Board-Folk/Neptune/helpers/Neptune-Region-Fix/images/Nep_rf_1.jpg

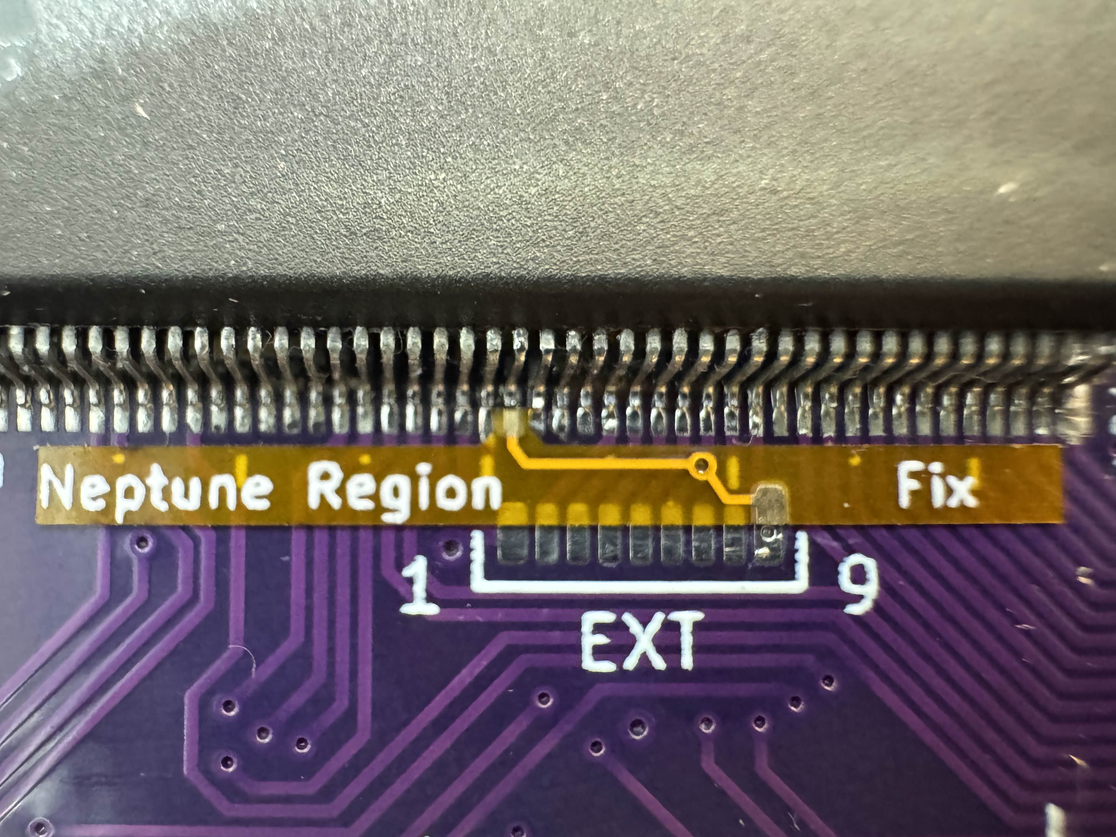
helpers/Neptune-Region-Fix/images/Nep_rf_1.jpg
