Board-Folk/Neptune/helpers/Neptune-Region-Fix/images/Nep_rf_2.jpg

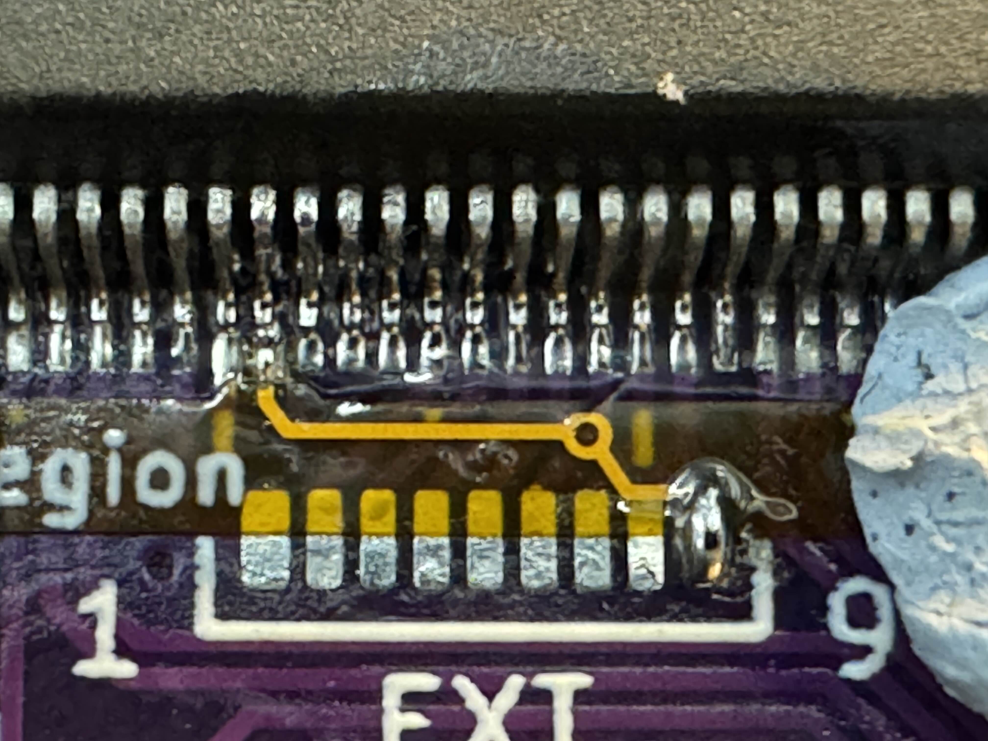
helpers/Neptune-Region-Fix/images/Nep_rf_2.jpg
