Board-Folk/Neptune/helpers/Neptune-Region-Fix/images/Nep_rf_3.jpg

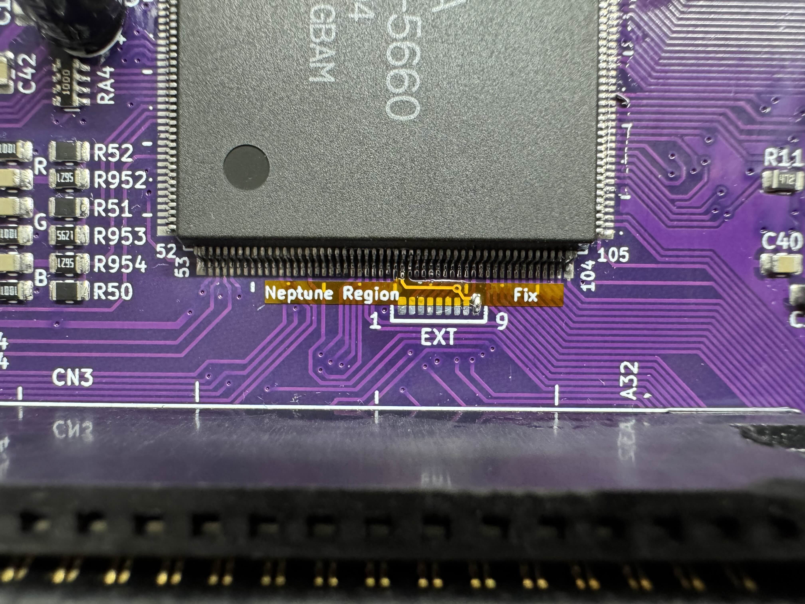
helpers/Neptune-Region-Fix/images/Nep_rf_3.jpg
