Board-Folk/Neptune/helpers/Neptune-Region-Fix/images/Nep_rf_4.jpg

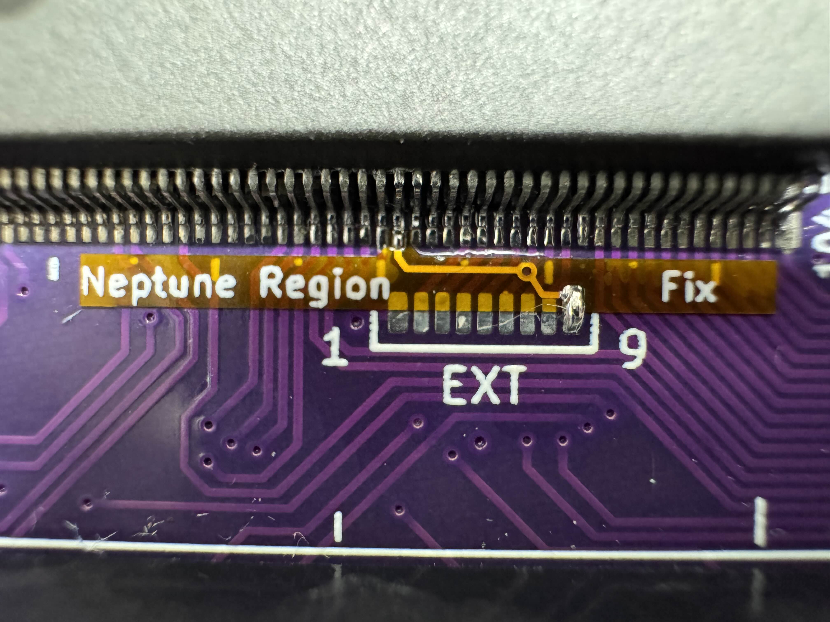
helpers/Neptune-Region-Fix/images/Nep_rf_4.jpg
