Board-Folk/Neptune/(threads)

Thread 1 (2025-01-19):

BOM Contains only minimal information

DoctorDan1986, 2025-01-19:
I'm astonished that the iBOM does not contain any information regarding capacitor voltages or tolerances.  Are we just supposed to throw 16V+ 0.1% parts at everything?

SteveMaddison, 2025-01-20:
1000 apologies (+/- 5%) that the BOM does not meet your standards. The first step would be to adjust your expectations; this is a hobby project with limited resources, worked on in normal people's spare time and provided free of charge. Second step would be to apply common sense as opposed to sarcastically proposing ridiculously narrow specifications.

The capacitor voltages are not even on the original schematics in most cases. They are however, rather conveniently, printed on the actual parts fitted to the donor hardware you would need to obtain in order to populate the board. As for tolerances, typically 20% is adequate for this kind of system. There are also capacitor lists for both the MD2 and 32X online. One can even order complete kits for these consoles from various suppliers.

I shall, time permitting (unless some kind soul were to offer a pull request for this) transfer the voltages where known to the BOM but, frankly, this kind of entitled attitude does not exactly inspire great motivation to do so.

dubesinhower, 2025-03-08:
I know it's not a perfect solution, but if you use the PCBWay plugin to send the project from KiCad to PCBWay, the plugin does some decent LCSC part mapping. You just need to download the generated BOM from the PCBWay order page.

From there, I deleted all rows with no LCSC part mapping (these parts can be obtained from the donor boards), and parts with values that start with "*".

Then upload that BOM to LCSC and see what issues need to be resolved (combining duplicates, finding replacements for OOS parts, etc).

You will also need cap kits for both the genesis 2 and the 32x, I got mine from Console5.

Note that I have a PCBWay sponsorship, but I thought this advice was helpful even if you don't plan to order the board from them.

I am not affiliated with Console5.

Nascar1243, 2025-03-11:
Is there any way this BOM could be converted so that I can use it on sites like Digi-Key or JLCPCB as I already ordered the board but need to get the parts and the BOM does not convert well at all with Digi-Key's site.  I don't want to manually enter in 100 different parts if I don't have to.

SteveMaddison, 2025-03-12:
There are some DigiKey part numbers in there, the column may need to be unhidden. Also the MPN is in there for most parts and can be used to order from various suppliers.

dubesinhower, 2025-03-12:
Also it doesn't seem to do anything with the PIC and the LED, so you may need to order some parts manually

Nascar1243, 2025-03-12:
Yeah I got them after getting a new BOM with KiCAD, although I am noticing a lot of caps with * as their value, what do I need to do with them?

dubesinhower, 2025-03-12:
AFAIK these are "DNP" or do not place and you can ignore them, but I haven't confirmed that yet

SteveMaddison, 2025-03-28:
The "*" is how they're labeled on the original schematics and means that the value (or presence in some cases) differs between various revisions/regions. The known differences are listed on the schematics to avoid trying to explain it all in the "value" field of a component. Sega also loved to place low value caps on various signals to compensate for timing issues in the hardware, so I've kept footprints for most of those just in case some revision happens to need them. The basic rule is to use what's on your donor - if it doesn't have it, it was never required in the first place.

dubesinhower, 2025-03-28:
> The "*" is how they're labeled on the original schematics and means that the value (or presence in some cases) differs between various revisions/regions. The known differences are listed on the schematics to avoid trying to explain it all in the "value" field of a component. Sega also loved to place low value caps on various signals to compensate for timing issues in the hardware, so I've kept footprints for most of those just in case some revision happens to need them. The basic rule is to use what's on your donor - if it doesn't have it, it was never required in the first place.

yea I'm just now learning that I was incorrect about the * parts!

SteveMaddison, 2025-03-29:
That sure looks like the diode indeed. The small resistor-looking thing may be the capacitor or there might not be one, not sure.

Silverymoon-lab, 2025-04-29:
This [document ](https://limewire.com/d/FRYD1#cw5XeDaozu)could have the information you are looking for.

Closed 2025-06-06.

Thread 2 (2025-03-27):

Request for clarification on some parts

jjh13, 2025-03-27:
I'm building this out from a VA1 NTSC genesis motherboard (and a VA0 32x), for the most part everything is going very smoothly. But I'm having a few issues with the labels of some components. My notes so far:

- The resistor arrays look mislabeled: RA3 should be a 2x package on the mega drive (RA6 is the 2x in the schematic); not a huge problem, since they're all the same value, but it's worth noting this (this tripped me up for a hot second).
- Looks like there also aren't enough 22nF capacitors on an NTSC motherboard to salvage. I have a second donor board, and ordered a bunch of additional parts so I'll be good.
- C15 is missing on all my VA1 motherboards; so I assume it is to be omitted. Might be worth noting.
- Is R45 supposed to be 0 ohms? It's definitely non-zero on the mega drive (I can't see it well without a microscope, so I can't read the rating). Perhaps it should be labeled R545? Although I don't know what R545 is, I'd need to look at my 32x (edit: yes R45 is 0 ohm on the 32x).

It's a very fun build so far though; I appreciate how well documented the project is despite one or two little hiccups.

SteveMaddison, 2025-03-28:
Thanks for the feedback.

* I've swapped RA3 and RA6
* R45 was meant to be the 32X part, is now R545

For donor parts, it's about transferring what's on the donors to the new board. What's not on the originals isn't required. I think you've figured it out but I've added a general note about it to the README.

Good luck with the build! I'll close this issue now but feel free to open another if you notice anything else.

jjh13, 2025-03-28:
Thanks! l verified as much as I can with the MD portion (probing around, I'm seeing signals that I expect, and my model 1 CD boots games; I think... not that I can see them...)  I'm moving on to the 32x portion of the build later tonight; I think I noticed some differences, but I'll take notes then open a new issue if there's anything meaningful (I need to study the schematic a bit before I jump into it.)

Closed 2025-03-28.

Thread 3 (2025-05-21):

Region of system flickers in 240P Test Suite, Gentest Test Rom, and Version Register flickers between A1 (81 if Sega CD is attached), D5, and FF

noobguy57, 2025-05-21:
When using 240P Test Suite on the Neptune, in the bottom right corner you will notice the region of the system flicker between North America and Europe. Further investigating this, on the Gentest Test Rom, the region also flickers back and forth rapidly, and the version register flickers rapidly from A1 to D5 and even FF (which shouldn't be possible).

This seems like a minor issue, and the Neptune passes the MARS Check ROM repeatedly, as well as passing all memory tests in the Gentest Test Rom for the 68000, Z80, and VDP, however in some games there is visual artifacting on the screen. The best demonstration of this is in Streets of Rage 2. The artifacting appears in NTSC mode, but goes away in PAL mode (however the version register and region still flicker in PAL mode).

This also seems to affect Sega CD reliably booting, although the full extent we have not troubleshooted, and a few resets eventually allow this to boot.

[Video](https://cdn.discordapp.com/attachments/817807363050307654/1373788908755619942/IMG_8566.mov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) of the region flicker and register (happens in 240P Test Suite too, and DOES NOT happen with same ROM and same Everdrive on a Tower of Power).

[Video](https://cdn.discordapp.com/attachments/817807363050307654/1373507720606646302/IMG_7538_2.MOV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) of the artifacting in Streets of Rage 2 in NTSC mode (possibly other games too, once again DOES NOT occur on Tower of Power)

This issue occurs on 8 people's Neptunes (as of what we know) with everyone in the Dubesinhower discord having this issue.
This issue also occurs across installs that were both pre-populated birdseed and hand installed birdseed, as well as different PCB manufacturers.

Here is what has been done to troubleshoot:
Verify clock signal with oscilloscope, change crystal, and install Dual Frequency Oscillator (no change)
Verify no shorts on VDP, 68000, Z80, and their respective RAM
Removed PIC and hardwired NTSC or PAL mode to test (no change)
Ensured proper NTSC components installed, and PAL components removed
Ensured proper instructions followed for the diode or SCA chips
Lifted the NTSC pin on the Genesis VDP and tied directly to 5 volts (no change)
Tied a 4.7k resistor between NTSC and 5V at PIC location (no change)
Verified connection of all CLK related lines on board
Verify NTSC line from Genesis VDP is held high all the time via scope (it is held high)

And finally, [here](https://cdn.discordapp.com/attachments/817807363050307654/1373795796306235532/20250518_175341.mp4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) is Streets of Rage 2 on my tower of power, not showing these symptoms, [as well as](https://cdn.discordapp.com/attachments/817807363050307654/1373795565703397428/20250518_175200.mp4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) the same Gentest Test Rom showing a stable region and version register.

We are all out of ideas for what could cause this. At first, when it was one person, it seemed like a short. But then every single person without fail? Now we aren't sure where to go or what to look for next. Any ideas or possible remedies to try?

SteveMaddison, 2025-05-22:
Just adding an extra source of information on the different ASICs we might come across and their known limitations.

https://consolemods.org/wiki/Genesis:ASIC_Information

It would be interesting to see how similar these all are internally but I don't know of anyone decapping any of these chips.

noobguy57, 2025-05-22:
I know some of them contain block diagrams that were from Sega, but not all of them. In the case of the 5660, the NTSC/PAL line is visible on there. Looks like a basic buffer going into the IC, then heads to some bus related lines. Some of the others don't have the block diagram which is annoying. I also don't unfortunately know if anyone has decapped one as well.

Is your build a pure PAL build? Does the region also flicker in 240p Test Suite?

So far we are out of ideas. We also tried with and without the cap array on the data lines from the 68000 going into the VDP, but no change in behavior there either.

dr-goobur, 2025-05-26:
@noobguy57 would you mind re-uploading/posting your videos? I'm not seeing any obvious signs of the region switching you're mentioning in the 240p test suite -- all of my 5 units show no sign of this problem (I think, but I'd like to be sure).

noobguy57, 2025-05-27:
This would be great to try. We believe its on the Genesis side, but it would eliminate 32x bus noise which would give a clue. If you have the means to do this, give it a go!

dr-goobur, 2025-05-27:
> The register isn't actually a physical register. When you read from that register, the NTSC, JAP, and DISC lines gets put to the data bus, which therefore outputs its value. Originally I thought it was a physical register too, but that address simply allows for those lines to be pulled to the data bus and output. So it may be an issue with that bus or noise/impedance on those lines, but we haven't had any huge evidence towards it. As for pulling the 32x VDP high on that line, I don't believe anyone has tried or on the encoder side. People have mainly tried on the Genesis side. Worth a shot!

That makes sense. A physical register (regardless of it being DRAM or SRAM) would be wasteful, and you could very well just multiplex (NTSC, JAP, DISC, 0, 0, 0, 0 ,1) on to the bus.

I lifted the NTSC pin on the video IC; the console boots (IIRC from the service manual, this is pulled high internally) but there's no change.

I'll lift the pin on the 32x VDP (and pull up if necessary) and see if that changes anything.

Although if there's no physical register in the VDP, then I suspect the problem to be on/with the 68k bus. We should removing  the 32x components as @v00dooperson suggests. I don't have the bypass flex cables, but I can remove the 5781, 5818 and 5805 and boot into gentest via a SegaCD (I've tried something similar when debugging my builds, the 5788 still partially works with this configuration, so you get some video out)

I just need to wrangle a windows PC to build the gentest diagnostic iso (and find my stack of blank CDs)

noobguy57, 2025-05-27:
Yeah I am feeling that we are looking at bus noise, I wouldn't count out the Z80 since the 68k accesses Z80 memory starting at $A00000

dr-goobur, 2025-05-28:
I can confirm that the Sega CD will not boot without a Z80 -- it was worth trying. The Z80 is easy to get off (and back on) the board. A thought tho, is it possible to boot without the Z80 if the 5660 never touches the Z80 bus?

I don't see anything in the [TMSS](https://github.com/OrionNavattan/TMSS-Disassembly/blob/main/tmss.asm) that would prevent us from booting without a Z80 (can I get another pair of eyes on that to validate this, thought?). If we use a specialized build of GenTest without any Z80 init, it might be enough to get some code running without a Z80 and see if we can observe the issue. I can burn that to a ROM and build a test cart (to eliminate any chance of a flash cart doing some Z80 init when the menu loads).

I'm really running out of ideas, and I'd like to validate anything we possibly can.

One other line of thought I've been having, is that the caps on the Neptune board are not exactly 1-1 with their counterparts on the original VA1 board. For example, take C52 on my original VA1 board. It's is populated with a 28nF cap (I took it off and measured, should be 22nF according to the VA1 schematic, but I guess that's in spec enough).

C52 looks like it's additional filtering for CE30. The closest equivalent I can find on the Neptune board is C32 (there's no C52). This isn't a problem per se, but it suggests that there could be other labelling issues on the Neptune board. If there was a mistake in the VA1 schematic that @SteveMaddison used as reference for the genesis side of the Neptune, then a naming error could mean that the equivalent component on the Neptune is out of spec (which would affect builds that take all components from the Genesis).

Has anyone transcribed the VA1 schematic into KiCad and laid out a replacement VA1 board? That'd be a good reference to have.

We should probably cross reference the caps/resistors on a VA1 board with their respective locations (not names) on the Neptune boards.

I also have a cheap 8 channel logic analyzer I could hook up, but I don't really know what I should be probing (8 channels is sorta limited, I could probably get a few lines on the address/data bus). I'd like a more specific test-rom before diving into that (i.e. one that reads A10001 over and over in quick succession, just so that I have a high chance of seeing reads from that address). I'm not opposed to buying a 32 channel logic analyzer, but that'd take some time for delivery.

dr-goobur, 2025-05-28:
> You should be able to ensure that the GenTest ROM does not contain any code that accesses the Z80. However, the 5660 does have direct connection to the Z80. The Z80 address and data lines head straight into the 5660. My guess is that it still wouldn't boot. I do have the GenTest source code if we need to make modifications for it. However yes you are right, it would be absolutely best to burn onto a ROM chip since the Everdrive has a very high chance of initializing the Z80.

> In the TMSS source code, the lea into SetupValues is important to note. You can see it loads the Z80 bus request and uses that address in a1 to do some simple and cycle saving math to get to the version register and find the console version. Since you did say you got a TMSS screen without a Z80, we could try to modify the ROM and see. I might heavily modify the ROM so that it only goes to the status screen and shows the version register/region.

The appearance and disappearance of the TMSS suggests that the console is executing code on the m68k, then handing off to cart. However, I need to have the 32x part of the build installed to see the TMSS screen (and I have no idea whether the 32x has a boot rom that runs on the 68k prior to handing control over to a game; that could feasibly init the Z80). I'll look into this probably tomorrow (I have to find my EPROM programmer and UV light; plus I have some plans tonight.)

> I don't think anyone has transcribed the schematic, I think that is a good idea though. My guess is [@SteveMaddison](https://github.com/SteveMaddison) would have more context on some of those components. When I talked to some of the folks that help develop Genesis emulators, they suggested simply looking at the address and data bus of the 68k and Z80 with an oscilloscope and to make sure all the edges look very clean, things like that. Logic analyzer you might be able to get the entire Z80 data bus with just those 8 channels, which is what we are looking at anyways. Could help rule in or out the Z80.

I've been probing the M68k address and data lines with my scope. (I haven't thought to probe the Z80 lines, because they're on the back of the board, I'll try that at some point). TBH, I'm not exactly sure what "clean" means here. There's what I would call "strange behaviour" on some of the m68k address lines, and the data lines look wonky. But I see that same behaviour on my model 1 (no 32x, just booting the test rom from CD, and the problem is not present on my model 1). I've been avoiding mentioning this because I'm not sure if my test setup is reliable, and I don't think I quite have the "golden eye" to determine a signal's quality.

I'm not confident that the logic analyzer I have will be useful, but I'll also give that a shot -- I say 8 channels, but it's really only 7 because one's dedicated for a clk signal (I think, I don't have it in hand right now). I'll probably buy the 32 channel analyzer anyway (because I want it), but it'll be a while before it gets here and becomes a viable avenue for testing.

Side thought: Perhaps we should branch off GenTest and fill it with a suite of debugging tools for Neptune builds. I have a list of features I'd like from a Neptune test CD (since I do all my testing throughout the build process with a Sega CD). Although, for now I only really want the reads from A10001 blasted to the screen. I understand the code well enough to do this, I think.

dr-goobur, 2025-05-29:
Double posting, I know, but it might be worth talking about.

I'm cross referencing the Neptune schematics with the Genesis VA1 schematics, looks like there's more discrepancies in the filtering for the 5660.

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
So far I see:

 - One cap missing; it's one that I already pointed out, I'm not sure exactly where it's missing though, because it seems like C32 took its place.
 - The resistors R72 and R73 are missing from the Neptune. I was aware of this, but I thought it didn't make a difference. However, they're suspiciously close to the NTSC line, and they look like they're somehow there to limit current. Without them, perhaps something is being charged or discharged too quickly, leading to values being corrupted in some way. Total guess. Maybe @SteveMaddison you can chime in on what those resistors do, and whether or not they may be important.

dr-goobur, 2025-05-29:
Those just connect to the various VCC lines on the 5660, but I don't think they're relevant. I lifted pins 54 and 57; if that affected the register at all I would have seen some change, but no change.

Also, turns out gentest boots fine without the Z80, no adjustments needed (can't boot from a flash cart tho). However, without a Z80, there's no change. I think we can rule out the Z80.

I also tried manually powering the system with a bench supply; no change.
I over-volted to about 5.2v, no change.

Oof, I'm running out of ideas. This appears to be very isolated to the 5660. I'm really going to have to dig into the genesis schematics and continue to cross reference the Neptune schematics.

Perhaps it /is/ simply related to some clock shift and the 18ns shift was too loose, I'll try to get a better setup for probing more signals (I want to capture traces of all the important control signals to the M68k relative to the clock and see if there are any timing discrepancies ).

After that idk. I might call it quits for a bit until I can get a reference model 2 that I can do some experimental surgery on (I'd like to swap in a problematic 5660 to the reference board and see if the issue goes away).

angelsix, 2025-05-29:
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

you need to compare the address and data bus with the !READ pin to see the moment at which the bus sends out the register, what the address is. Or at least compare the rise/fall of the !READ pin vs any address/data to see if it is aligned different than stock

dr-goobur, 2025-05-29:
READ isn't the signal you should care about, that's not quite how the m68k works; READs aren't available in the next cycle, there's a variable delay until the data is on the bus (in theory; but I bet on the genesis it's fixed). It's more reasonable to probe DTACK because it's the acknowledgment that data is valid on the bus.

That being said, I did check read. I actually checked all control signals off of the m86k and I didn't see anything overly suspect. I will get better traces of those when
 1) I have a reference model 2 to compare against
 2) I figure out how to automate my scope setup (saving waveforms on my scope is not trivial for some reason) But even then, getting the exact.
Even still, getting this to trigger on the exact instruction that shows the problem is not trivial, especially since it's a relatively rare occurrence. The easiest thing I can do is compare the waveforms of the signals to the clock to see if there's any deviation from what's expected. If there is, then we can conclusively say that's a problem. If there's no deviation, then it's inconclusive (imo).

I'm stowing that idea for now because it's hard to test, and isn't logically consistent with how the system is operating. For example, if there was a clock shift causing the m68k to read data at the wrong time, it would likely affect other reads, which would quickly lead to a crash. This seems VERY isolated to this single register. See the block diagram below.
 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

The signals in question (JAP, NTSC, and DISK) are buffered, then put on to an internal bus in the 5660. That bus is also used for other reads.

Actually, what's interesting about this diagram is that AD0-AD7 and RD0-RD7 are on the same bus as JAP, NTSC, and DISK. AD0-AD7 and RD0-RD7 are also unbuffered, so if the timing of when the VRAM chips present data is off, then it might still be driving those busses (AD0-AD7 is most suspect, RD is disconnected). I'm questioning C15-C18 now, and also RA3 and RA4.

dr-goobur, 2025-05-29:
I mean, I really hope that putting the 5660 back in an MD2 makes the flicker go away. I'm also pretty confident it will, but at this point it's worth checking. If the 5660 is somehow damaged by being installed in the Neptune (unlikely imo) then all the debugging we've done is moot.

Although you mentioned something that made me think: In Streets of Rage, the artifacts we're seeing are CRAM dots from DMA, yes? On the title screen, they happen pretty consistently in the same place (although the interval between frames is pretty random).

To me, this suggests there's some regularity to whatever is causing this issue; if we could figure out some trigger condition (like HSYNC + some delay), then I could maybe get a capture of some important signals (address lines, data, etc...).

That being said, I'm pretty burned out on this, and I need to take a break; I've been neglecting other aspects of my life trying to root out this issue. I'll keep thinking about it, but I'm not going to do any more testing (probably) until I get a reference model 2 to work with.

dr-goobur, 2025-06-02:
I have an interesting observation.

I've been trying to get more debugging information out of the Neptune. I modified the gentest ROM to output some data over controller port 2 via serial to get a better sense of how often the region error occurs. Turns out the serial port is broken, too.

I tested on 2 Neptunes and observed the same problem.

To validate, you can use this ROM https://github.com/rhargreaves/mega-drive-serial-port and check for

From my model 1 I receive the expected `012345689\n`
on my Neptunes I get (from my debug utility)
```
Received byte?: b'\xe2'
Received byte?: b'('
Received byte?: b'\xe0'
Received byte?: b'('
Received byte?: b'\xe8'
Received byte?: b'`'
Received byte?: b'\xe8'
Received byte?: b'('
Received byte?: b'\xe0'
Received byte?: b'('
Received byte?: b'\xe0'
Received byte?: b'`'
Received byte?: b'\xe8'
Received byte?: b'`'
Received byte?: b'\xe0'
Received byte?: b'`'
Received byte?: b'\xe0'
Received byte?: b'h'
Received byte?: b'\xe0'
Received byte?: b'`'
Received byte?: b'\xe0'
Received byte?: b'`'
Received byte?: b'\xe8'
Received byte?: b'('
Received byte?: b'\xe0'
Received byte?: b'p'
Received byte?: b'\xe8'
Received byte?: b'`'
Received byte?: b'\xe8'
Received byte?: b'`'
Received byte?: b'\xe0'
Received byte?: b'`'
Received byte?: b'\xe0'
 # output continues...
```

noobguy57, 2025-06-02:
Very interesting. I'll have to look into the serial port stuff and see if I can come back tomorrow with a hardware answer as to what the typical process is on a model 2 ASIC.

noobguy57, 2025-06-02:
> Yeah, that'd be helpful. I still only have a model 1, and I ran this without a 32x. That being said, I do expect this to work with a 32x; IIRC the doom port allows multi-system multiplayer over the serial port via controller 2.
>
> This is sorta suspicious. Look at the block diagram, the IO controller touches the same bus that the JAP, NTSC and DISC are on (it writes to it, tho. so it shouldn't be bugged by any issues on that bus?)

Yeah that's what I drew out on the block diagram drawing all those posts ago. So we wrap back a bit to our original suspicion, the I/O controller area. We should investigate those lines.

dr-goobur, 2025-06-02:
Ha, found it. All of our theories were wrong :) it's a very simple mistake. I'll give ya'll some time to take a look for it, and I'll submit a PR to fix the issue later tonight.

noobguy57, 2025-06-02:
I'm not gonna lie I'm too dumb to find it myself. Does it also fix the serial bug?

noobguy57, 2025-06-03:
God damnit, I see it now in the service manuals. Pin 81 on the 5660 information says "(Set to "0" certainly.)" and the rest are all set to open (82, 83, 84). Had their wording been better I'm sure you would have caught it earlier. And yeah it's not really on any of the schematics in the service manuals either.

dr-goobur, 2025-06-03:
It's obvious in hindsight, but easy to miss. It's also an easy mistake to make. Thankfully the fix is also super easy (no pin lifting, component changes, etc... just some slightly finicky soldering). Also, the updates to the board are dead simple.

Can somebody please independently verify that this fixes the problem? Once that's done we can close out this issue.

noobguy57, 2025-06-03:
> It's obvious in hindsight, but easy to miss. It's also an easy mistake to make when the board was being laid out. Thankfully the fix is also super easy (no pin lifting, component changes, etc... just some slightly finicky soldering). Also, the updates to the board are dead simple.
>
> Can somebody please independently verify that this fixes the problem? Once that's done we can close out this issue.

Someone in the modding server where this all originated (and the first person to notice) confirms that it fixed the issue. Thank you for your hard work and for listening to my rambles about all this, through trials and tribulations it has been fixed!

dr-goobur, 2025-06-03:
Also, just to close the loop on the serial port thing. It works now, too.

chris-jh, 2025-06-03:
Well done everyone, works great 😂

Stupid Sega, i kept that a capacitor was missed or wrong value.

What i did, could have done with thinner wire 🤣

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

Closed 2025-06-03.

Thread 4 (2025-05-28):

C15 should never be installed, VRAM does not function when installed and can only display the background color

RGBeter, 2025-05-28:
If this isn't the place to be asking for help, please delete this and point me in a proper direction, but I can't find anywhere else at the moment. Maybe it would be best for the instructions on this to include some troubleshooting instructions, and overviews of the genesis architecture not typically covered in the manuals.

In my case, I'm getting glitchy video, where the screen is just one color (that can change) when loading a Sega CD game (Sonic CD). For example, the screen is blue when showing the "SEGA" loading screen, then fades to black. The code itself is executing properly, as I can hear and even play the game, but something's wrong with the video.

There's just, minimal Neptune specific information or good test points.

On the other hand, a cartridge game (sonic 2) refuses to boot, hanging on a green screen, I traced the bus with a logic analyzer, and it seems like the data bus was weak/inconsistent. Despite manually confirming EVERY PIN on EVERY chip was soldered to its pad, and not short to its neighbors.

CD 32X games refuse to boot, so I suspect something on the 32X side of things, in particular 5818 since it's arbitrating the data bus.

Here's the logic analysis of Sonic 2's boot, in order from address, data, and w if it's a write. I repeated some addresses when the data bus behavior on it was inconsistent between clock cycles.

I don't know assembly to debug this further, and could use some help knowing where to look for both the video issue and the 32x issue, which could be one in the same but I don't know enough assembly for that.

Starting after the CPU jumps to the reset vector of 00202, comparison against a trace run of the same cartridge of sonic 2 on an unmodified VA2.3 model 2 genesis.
000006 0202
000202 0BFA
000202 4BFA
000204 006A
000206 4CDD
000208 1FE0
00020A 1029
00026E 0000
000279 8000
000272 0000
000274 063F
000274 001F
000276 3FFF
000276 0000
000278 0100
00027E 00A1
000280 1100
000282 00A1
000284 1200
000286 00C0
000288 0000
00028A 00C0
00028C 0004
00028E 0414
00020C 4701
00020C EF01
00020E 0200
A10000 A1A1
000210 000F
000212 0708
000212 2708
000212 6708
000214 237C
000216 5345
000216 0345
000216 5345
000218 4741
00021A 2F00
00021C 3014
A14000 5345 W
A14002 4741 W
00021E 7000
C00004 7208 (should be reading 0208 but looking at the control port info it might be fine?)
000220 2C40
000222 4E66
000224 7217
000226 1A1D
000226 021D
000226 1A1D
000228 3885
00028E 0414
00022A 0047
C00004 8004 W
00022C 0041
00022C 01C9
00022C 51C9
00022E FFF8
00022E 7DF8
00022E FFF8 (bad, should go back to 000226)
0042A6 9FBF (instead it jumps here, which is invalid)
0042A6 0807
0042A6 9FBF
0042A8 DFFF
0042A8 0801
0042A8 DFFF
FF7EFE 42A6 W
FF7EFA 2708 W
FF7EFC 0000 W
000010 0000
000012 0200
000200 007E
000200 00FE
000200 60FE
000202 4BFA
000200 60FE
000202 4BFA
stuck between 000200 and 000202 forever

RGBeter, 2025-05-28:
My everdrive loads to a white screen unfortunately, I suspected my soldering of 315-5818, but I painstakingly checked all 176 pins to no avail. If there's a sega CD version of it I could load that, but I'll need to navigate blind due to the weirdness with the VDP only showing one color of one object on screen.

I WISH it was my soldering, but I think something more evil is going on, removing the SH-2s or 32X VDP had no impact either. Swapping the ASIC had no impact either.

-Boots Sega cd (can't see it because of bugged graphics)
-Crashes the moment a 32x CD tries to load
-Cannot boot a cartridge (have not tested SMS I don't have a power base converter)

I wish this board had a means to get probes on some of these ASIC pins, I can't really perform logic analysis on things like 5818 or 5805.

somehow despite the state it's in, it IS actually passing TMSS, you can see the writes to $A140000 and $A140002 before any VDP access.

dr-goobur, 2025-05-28:
> If this isn't the place to be asking for help, please delete this and point me in a proper direction, but I can't find anywhere else at the moment. Maybe it would be best for the instructions on this to include some troubleshooting instructions, and overviews of the genesis architecture not typically covered in the manuals.
>
> In my case, I'm getting glitchy video, where the screen is just one color (that can change) when loading a Sega CD game (Sonic CD). For example, the screen is blue when showing the "SEGA" loading screen, then fades to black. The code itself is executing properly, as I can hear and even play the game, but something's wrong with the video.

Check your resistor arrays between the VDP and the VRAM (I believe RA1- RA6). Check for bad joints/bridges and make sure you have the correct values for those resistor arrays.

The system can boot with bad VRAM, but you can get all sorts of weird display issues.

RGBeter, 2025-05-29:
Well, after confirming that everything was fine with the resistor arrays, I swapped the VRAM onto a known working VA1.8 and it showed artifacts, so that chip was dead.

However, the Neptune still wasn't working quite right, so I swapped the ASIC from said working VA1.8 onto the Neptune. Bringing it back to black screen and likely no code execution.

Clocks are good and nothing's stuck halted or reset, I then went and swapped the Z80, it's RAM and the main system memory but it had no affect.

The only thing I can think of is the pal/NTSC bug presented in a different thread, this is a 315-5660-10, which has PAL mode disabled. It shouldn't be an issue since that pin is being pulled high, but I still don't know why else this working ASIC would behave worse on this Neptune. Either that, or the hot air killed it, but I doubt it, this isn't an RSX or anything, and those survive lead free rework temperatures.

No observable issues with the SMD components either...

noobguy57, 2025-05-29:
Hot air for too long could have potentially damaged it. Most opt to use low melt solder for removal. The RSX funnily enough can only survive 200c once (at the factory) and then it breaks itself if done again. Funny little chip. Currently dealing with PS3 issues of my own.

For the ASICs I would recommend double checking all the pins with something real small like a toothpick. A lot of people have had floating pins that arent visible to the naked eye.

RGBeter, 2025-05-29:
Complete black screen, nothing's happening other than sync generation. Sometimes I can get a cyan screen on a sega CD though.

Before with the precious ASIC I was actually getting the writes for TMSS, but never got the screen to show up. Which is why I went and replaced it since that's not what's supposed to happen.

BGA is only easier because I spent months learning it and a bunch of money, but the process is well documented, and there's a decent amount of people doing it that can help. A01s usually need a Frankie though and there's the -22 revision to deal with too which popcorn badly no matter what you do. The actual BGA process, once you have it figured out, is pretty much just hitting a button, and waiting for 15 minutes, before poking a chip and doing what you need to do. No sets of 208 pins that make me wish I was working with 0402 components.

RGBeter, 2025-05-29:
I will also mention sometimes the Sega CD itself is able to boot on its own, but I get zero sound output from the Genesis and the moment it attempts to load a game it crashes.

It's as though 5660 isn't powered correctly or something.

noobguy57, 2025-05-29:
The Sega CD not booting 100% of the time is actually caused by the region bug in the other system. So if it is booting, that means more is working than you think. Have you tried loading the 240p Test Suite for Sega CD? There's a debugger in there.

RGBeter, 2025-05-29:
> The 5660-10's PAL mode is only broken when the physical NTSC line is put low. That signifies its in PAL mode, and the ASIC may bug. The issue in the other thread has something to do with bus noise and NOT the actual NTSC line, so that shouldn't be your issue. However it is possible that your ASIC is dead. The Sega CD going through all that process is a good sign for other components.

Well, how would I go about confirming the ASIC's functionality without stealing the last known working one I have (a 5487 from my VA7 model 1, so pal will still be broken) and seeing what happens?

If I need to, I'm going to just use my BGA station to remove the thing, since clearly hot air isn't something it enjoys. Fortunately I don't have to reball these when I remove them :p

noobguy57, 2025-05-29:
What type of programming knowledge are you looking for? I do program on the Genesis if that's what you are referring to. However, if you are looking for online resources, Sega Retro VDP articles are very helpful for all details, and there's even some hobbyist writeups that help too.

If you want something even more hands on, download the Sonic 1 or Sonic 2 disassembly to see exactly how different programming methods are implemented, and they are fully rebuildable too so you can make changes and build the ROM.

If you check on my github you can see the Sonic 1 Practice ROM I worked on as further evidence of my Genesis knowledge.

noobguy57, 2025-05-29:
The VDP writes to VRAM tile data and sprite data. It also has its own CRAM and VSRAM but that is internal to the VDP. The VDP usually accesses VRAM by setting the address in VRAM where it wants to write to the control port, then sends the actual tiles or sprites to write there via the data port. OR, by using DMA, you can bypass using the control and data port and write directly to VRAM from the 68k.

Those opcodes should be traceable to a 68k command, however the problem is it's most likely an error trap loop in the program that is branched to when the 68k crashes by using a vector table at the start of the ROM. These tables can be seen in the disassembly.

https://segaretro.org/Sega_Mega_Drive/VDP_general_usage

There is also a guide on Sega Retro about DMA.

Luckily I have been able to pair my hardware knowledge with programming for the Genesis, my name is the same on discord so feel free to add me there and I can try to assist!

RGBeter, 2025-05-29:
I sent a friend request, I don't know exactly WHAT data gets written, but the TMSS screen should be a good starting point I think.

RGBeter, 2025-06-04:
Probably some strange issue with the VDP, it won't work with TMSS, but otherwise after removal of C15 it works.

A note should be added to the schematic to "NEVER USE C15" to match all model 2s and the model 2 service manual.

RGBeter, 2025-06-04:
Looking at all of the model 2s I have (all board revisions except VA0 and VA1) and my VA7, it seems like Sega only ever populated it for Toshiba ASICs, where C16 C17 and C18 weren't populated at all on the VA2.3.

Might be different for Fujitsu made ASICs (315-5708) or the 315-5700, but I've never personally done across one to confirm it.

Might also be different on Japanese and PAL systems, but they never even had Toshiba ASICs.

Closed 2025-06-04.

Thread 6 (2025-06-04):

Feature Request: Alternative package for OSC1

dr-goobur, 2025-06-04:
Genesis motherboards are designed to take two slightly different package sizes for the main crystal `OSC1`. Motherboards may use a larger or smaller package size depending on the variant; for example, I've run across a VA3 that used the smaller variant. I believe the common larger variant is a 14-DIP, (4 Leads) and the smaller variant is 8-DIP, 4 Leads.

It'd be nice if the board was laid out for both package variants; this was the only hold up I had building a Neptune from a VA3. I ended up stealing the oscillator from a VA2 board, and putting the VA3's oscillator in that board; otherwise there's no reason we shouldn't be able to simply use the entirety of a VA3 board.

SteveMaddison, 2025-06-04:
Yep, perfectly valid request and I think it came up before at some point. I'll look into it but the routing around the oscillator is particularly busy, especially on the bottom layer.

SteveMaddison, 2025-06-06:
Slightly funky footprint but this should work.

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

dr-goobur, 2025-06-06:
Yess; thank you. This potentially makes my life easier for future builds.

I appreciate it!

Closed 2025-06-06.

Thread 7 (2025-07-15):

D699 isn't needed, no matter the version of 5818.

RGBeter, 2025-07-15:
That diode listed as "SCA ONLY" isn't nescecary, and the term "SCA only" is wrong.

That bodge diode on VRES was used only on VA0 32X systems, which were capable of having both the gate array and SCA versions of 315-5818. VA1 32X systems, which ALSO can have both kinds of 5818 (though mostly the SCA) NEVER had this diode due to the elimination of its associated pulldown resistor.

I tested on my real 32x hardware, and on my neptune, that this diode isn't needed, including on my VA0 32x with both a gate array and SCA. So long as the associated pulldown isn't present, VRES works as intended.

This diode causes...far too much confusion and can safely be either always present, or never present (preferable).
