Board-Folk/Neptune/(commit log)

2025-07-05 Flex Region Fix Helper PCB
    [Neptune-Region-Fix.kicad_pcb, Neptune-Region-Fix.kicad_sch]
2025-09-11 Update documentation about D699, rename C695 to C553 to indicate origin (issue #7).
    [32X_main1.kicad_sch]
2025-09-11 Tie SH2 NMI pins to VCC as per original 32X main board (not obvious from schematic).
    [32X_main1.kicad_sch, 32X_main2.kicad_sch]
2025-11-13 Correct connection of C2 to VA21 (issue #12).
    [cpu.kicad_sch]
2025-11-13 Update bypass flexes for 315-5805 and 315-5818 for better connection (issue #11).
    [Neptune-32x-315-5805-bypass-B_Cu.gbl, Neptune-32x-315-5805-bypass-B_Mask.gbs, Neptune-32x-315-5805-bypass-B_Paste.gbp, Neptune-32x-315-5805-bypass-B_Silkscreen.gbo, Neptune-32x-315-5805-bypass-CuBottom.gbr, Neptune-32x-315-5805-bypass-CuTop.gbr, Neptune-32x-315-5805-bypass-EdgeCuts.gbr, Neptune-32x-315-5805-bypass-F_Cu.gtl]
2025-11-13 Remove PAL-only designation from C11 (issue #10).
    [sge.kicad_sch]
2025-11-13 Add note for C11 (issue #10).
    [sge.kicad_sch]
2026-01-14 Connect controller port to PIC to support IGR (issue #13).
    [misc.kicad_sch]
2026-01-15 Extend zone under controller port screw.
2026-07-30 Route PA0 to PIC for IGR.
    [misc.kicad_sch]
2026-07-30 Add jumper for /M3 to PIC.
    [misc.kicad_sch]
2026-10-14 Make pin 1 indicators more consistent.
2026-10-14 Update README for switchless firmware update.
2026-10-14 Note about using new PIC firmware on older boards.
2026-10-14 Update schematic revision/date.
2026-10-25 Add note about 315-5660-10 ASIC pull-down resistor.
2026-10-28 Clearer pin 1 indicator for IC801.
